md-raz/projects-public/README.md

# projects-public
These are projects which I've worked on in the past. These projects were, or are now, made public and are no longer undisclosed. 

Each corresponding file contains information about a specific project.
