md-raz/projects-public/smart_power_strip/README.md

## Smart Power Strip
Image 1 Of Power Strip
### About the Project:
ESP32-WROOM (XTENSA) based “smart” power strip. Device connects to WiFi network and provides a webserver interface from which connected devices can be turned on or off. Power input directly from mains (120V @ 60 Hz). Incorporates the use of solid state [opto-isolated] relays to safely toggle power on and off. Proof of concept demonstration for moderate power and current applications on silver nano-particle inkjet PCBs.

### What I Primarily Worked On:
Designed the schematic, PCB design, and then fabricated the circuit. Programmed the processor using Arduino IDE (C++). Thoroughly documented creation of the device. Assembled and built device based on developed schematics.
Further information about the build process can be found at <code> https://www.botfactory.co/blog/what-s-new-at-botfactory-1/post/creating-a-smart-outlet-121 </code> 

Image 2 Of Power Strip

### Disclaimer
This project is intended to show how you can prototype with an SV2 PCB printer. It is not a product that you should use as an everyday item. It was neither designed nor tested to comply with appropriate safety standards. You are liable for any risk you take when using this design.
