md-raz/projects-public/smart_power_strip/Schematics/Smart Outlet.pdf

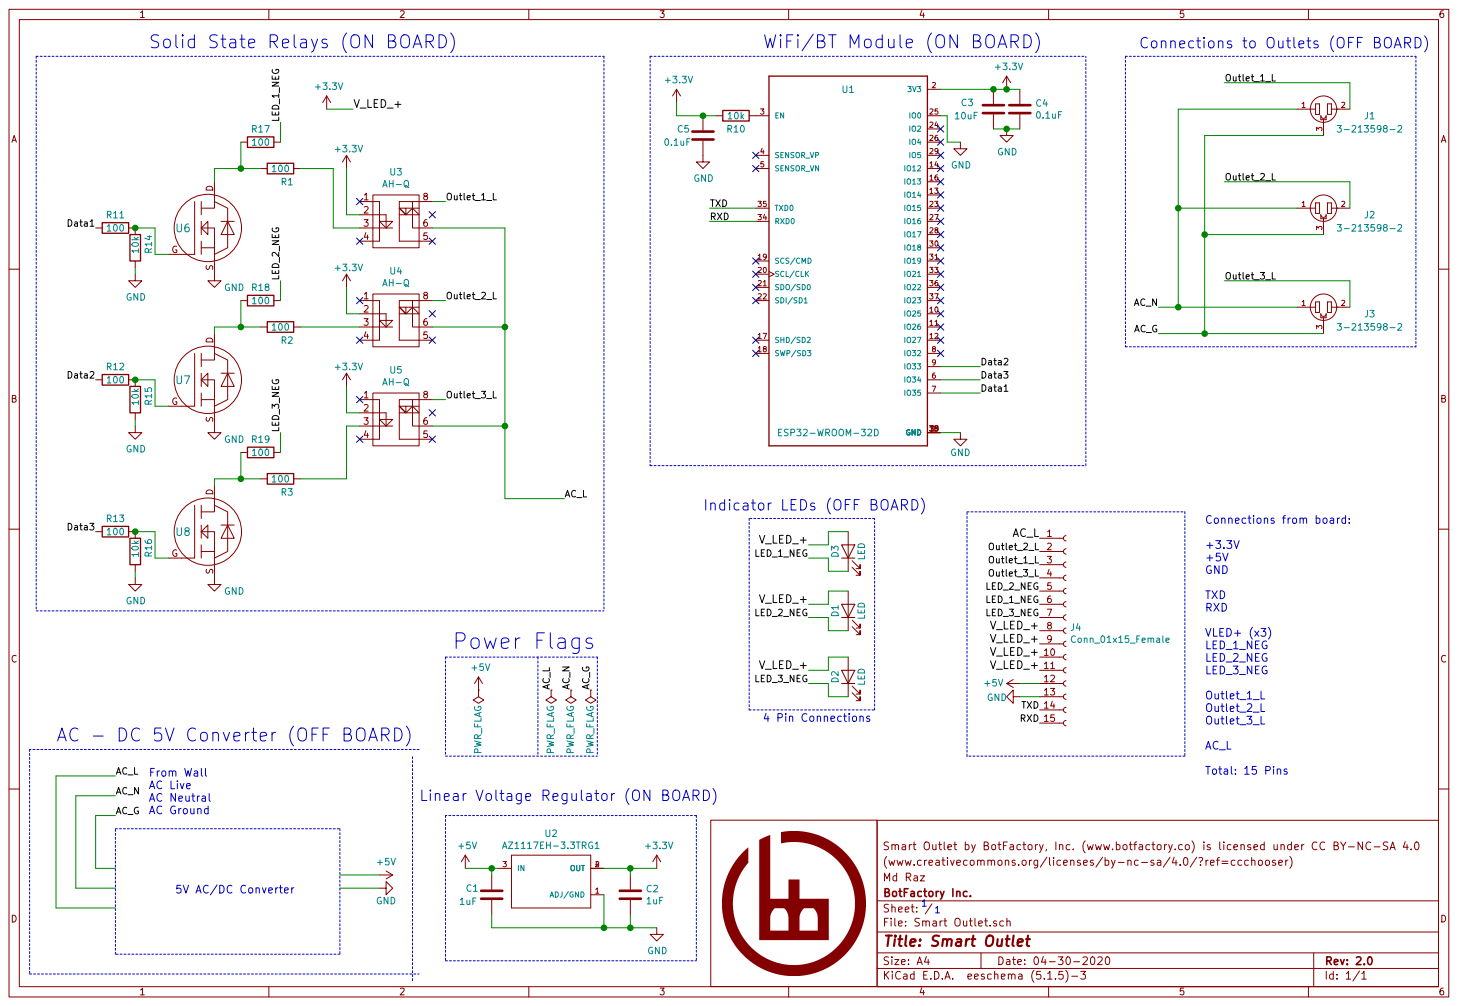
[picture p1: page 1]

Indicator LEDs (OFF BOARD) 4 Pin Connections 5V AC/DC Converter

1 Linear Voltage Regulator (ON BOARD)

Smart Outlet by BotFactory, Inc. (www.botfactory.co) is licensed under CC BY-NC-SA 4.0
(www.creativecommons.org/licenses/by-nc-sa/4.0/?ref=ccchooser)
Id: 1/1 Title: Smart Outlet File: Smart Outlet.sch Sheet: / BotFactory Inc. Md Raz
