md-raz/projects-public/smart_power_strip/Schematics/Smart Outlet.kicad_pcb

## KiCad design smart_power_strip/Schematics/Smart Outlet.kicad_pcb (2020-12-03)

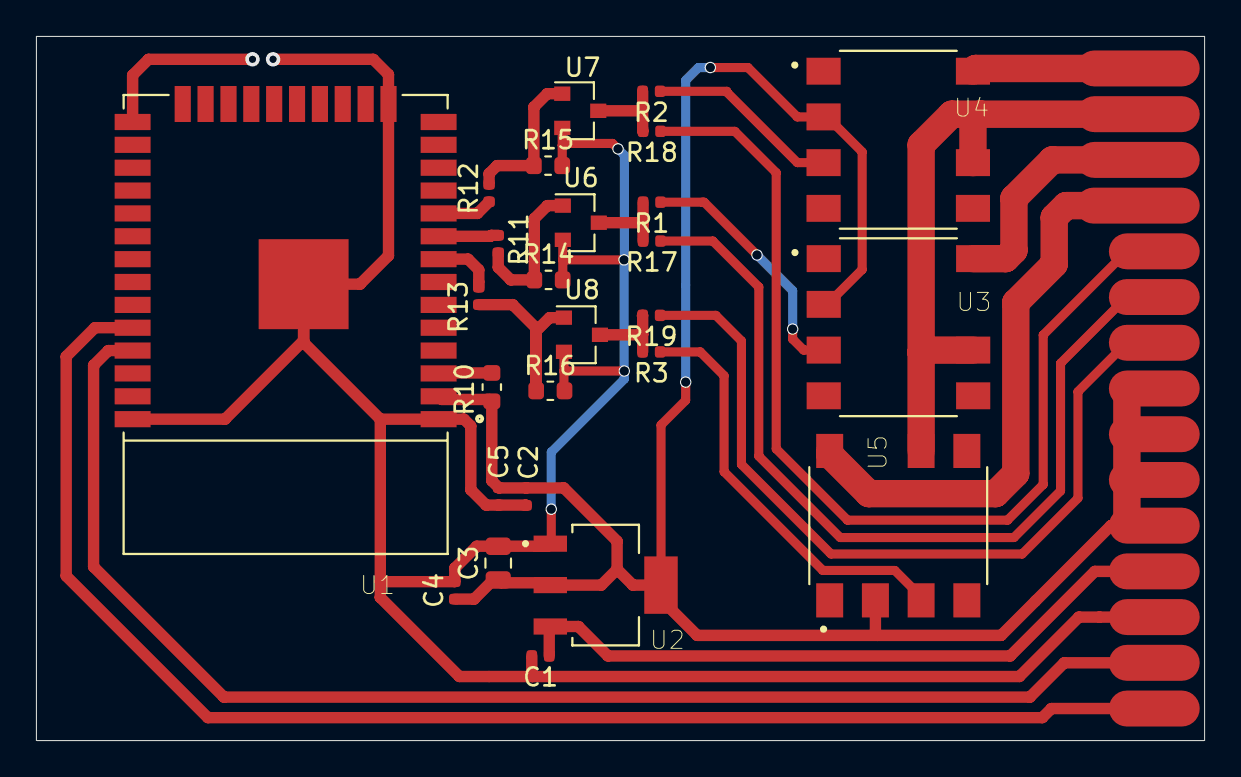
[picture p2: board Smart Outlet.kicad_pcb from above]

Board: 2 copper layers, 64.9 x 39.1 mm, 26 parts (0 on the bottom side), 17 nets.

Parts:
C1, C2: 1uF; C_0402_1005Metric
C3: 10uF; C_0805_2012Metric
C4, C5: 0.1uF; C_0402_1005Metric
R1, R2, R3, R11, R12, R13, R17, R18, R19: 100; R_0402_1005Metric
R10, R14, R15, R16: 10k; R_0603_1608Metric
U1: ESP32-WROOM-32D; MODULE_ESP32-WROOM-32D
U2: AZ1117EH-3.3TRG1; SOT230P700X180-4N
U3, U4, U5: AH-Q; RELAY_AQH3223A
U6, U7, U8: DMN2056U; SOT-23

Connections:
+3V3: C2.1, C3.1, C4.1, C5.1, R10.2, U1.2, U2.2, U2.4, U3.2, U4.2, U5.2
+5V: C1.1, U2.3
/AC_L: U3.6, U4.6, U5.6
/Data1: R11.2, U1.9
/Data2: R12.2, U1.10
/Data3: R13.2, U1.8
GND: C1.2, C2.2, C3.2, C4.2, C5.2, R14.2, R15.2, R16.2, U1.1, U1.15, U1.38, U1.39, U2.1, U6.2, U7.2, U8.2
unnamed: R1.1, U3.3
unnamed: R1.2, R17.2, U6.3
unnamed: R2.1, U4.3
unnamed: R3.1, U5.3
unnamed: R10.1, U1.3
unnamed: R11.1, R14.1, U6.1
unnamed: R12.1, R15.1, U7.1
unnamed: R13.1, R16.1, U8.1
unnamed: R2.2, R18.2, U7.3
unnamed: R3.2, R19.2, U8.3
